MrRyabena/SmartSpot/photo/SceneSpotManager_2x.png

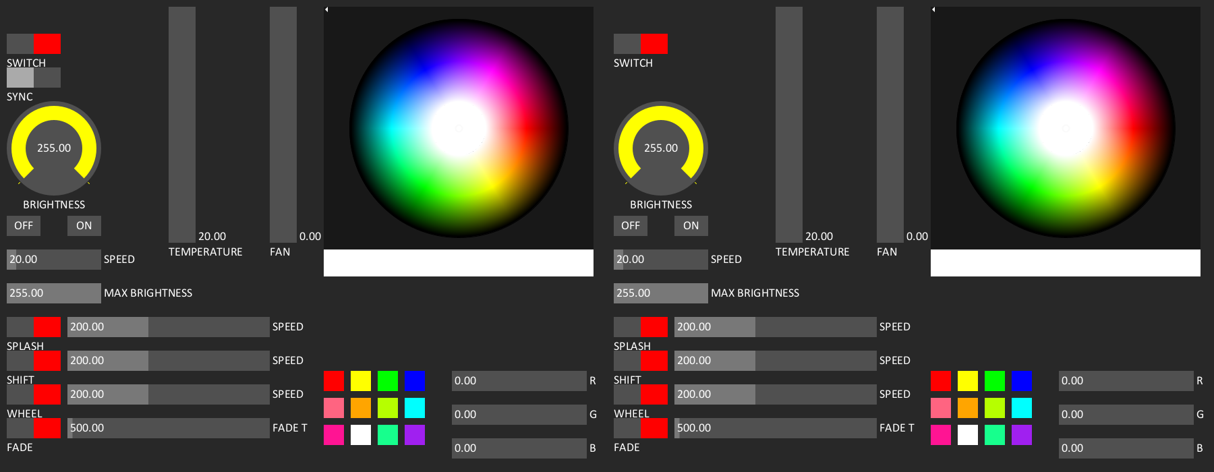
photo/SceneSpotManager_2x.png
