MrRyabena/SmartSpot/schemes/scheme_SmartSpot_v2.0.0.png

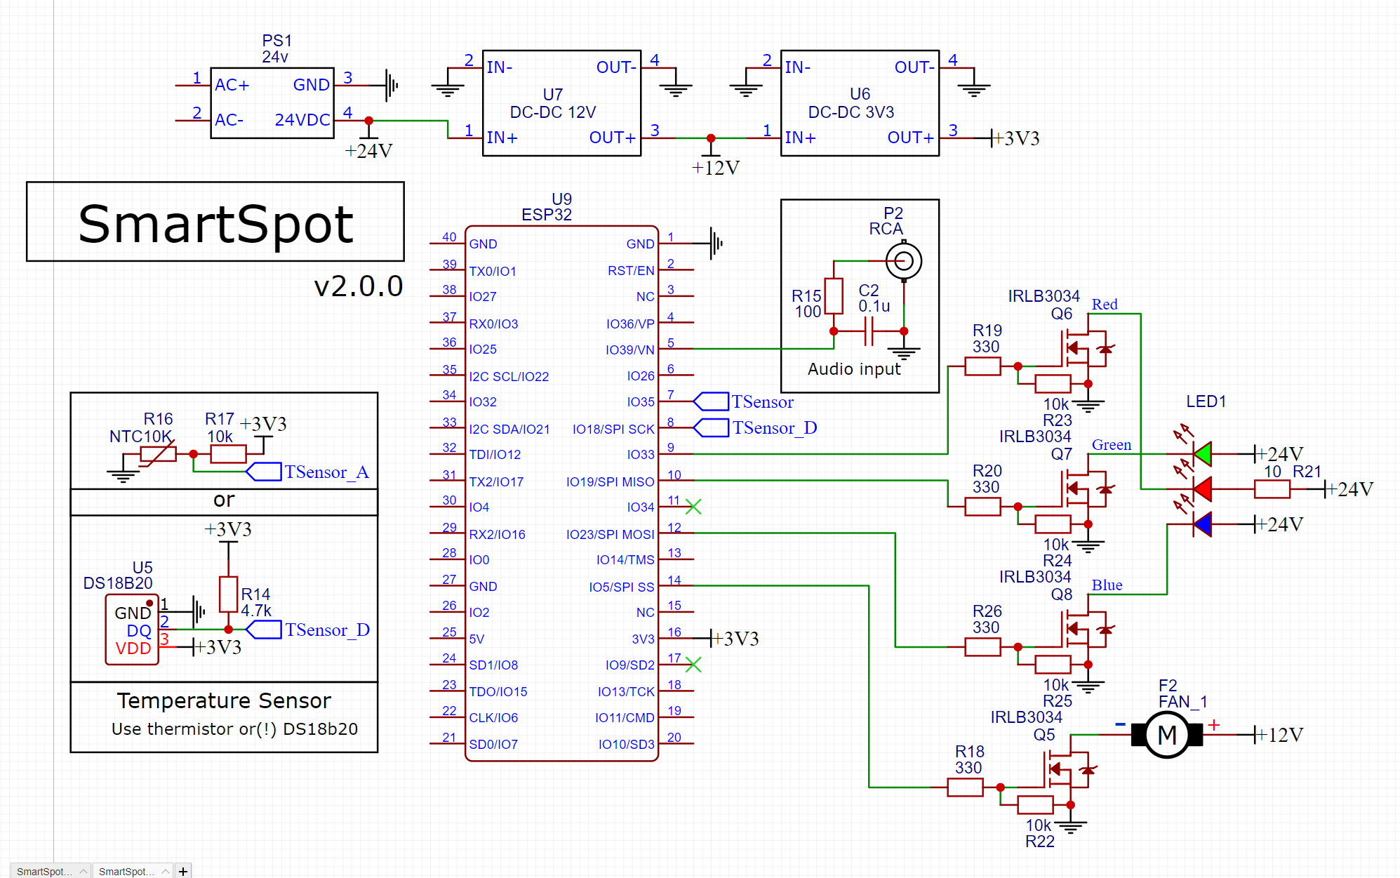
schemes/scheme_SmartSpot_v2.0.0.png
