MrRyabena/SmartSpot/schemes/smartspot_little.png

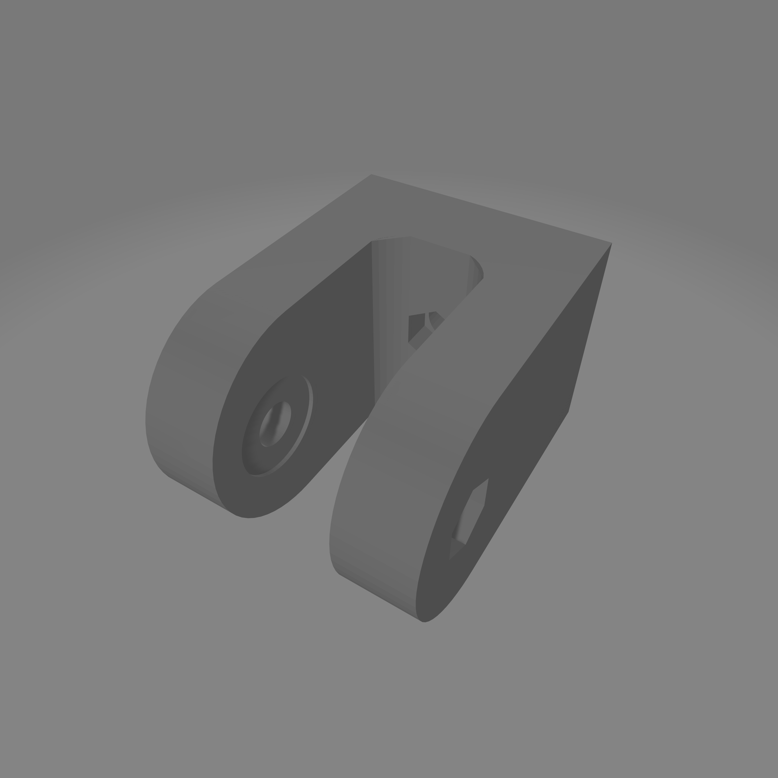
schemes/smartspot_little.png
