MrRyabena/SmartSpot/schemes/smartspot_lower.png

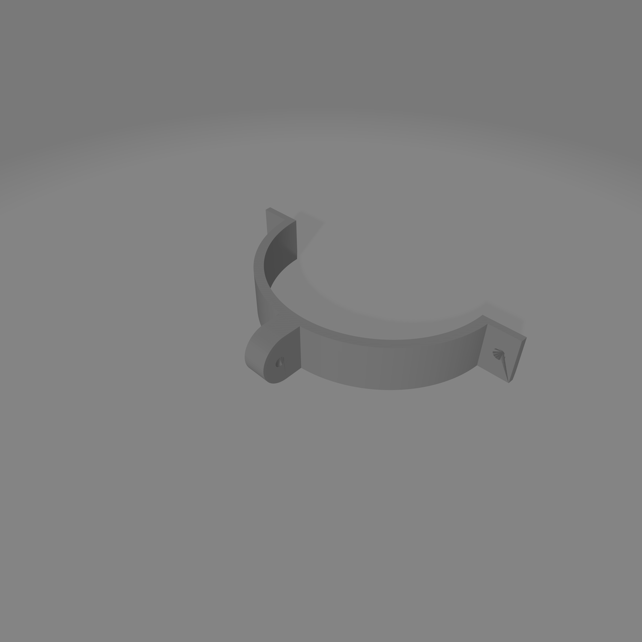
schemes/smartspot_lower.png
