MrRyabena/SmartSpot/schemes/smartspot_upper.png

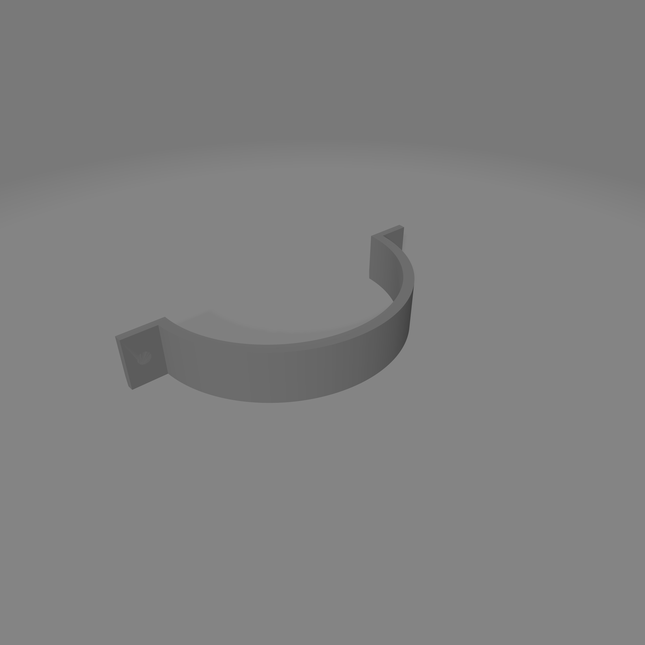
schemes/smartspot_upper.png
