MrRyabena/SmartSpot/3Dmodels/smartspot_little.obj

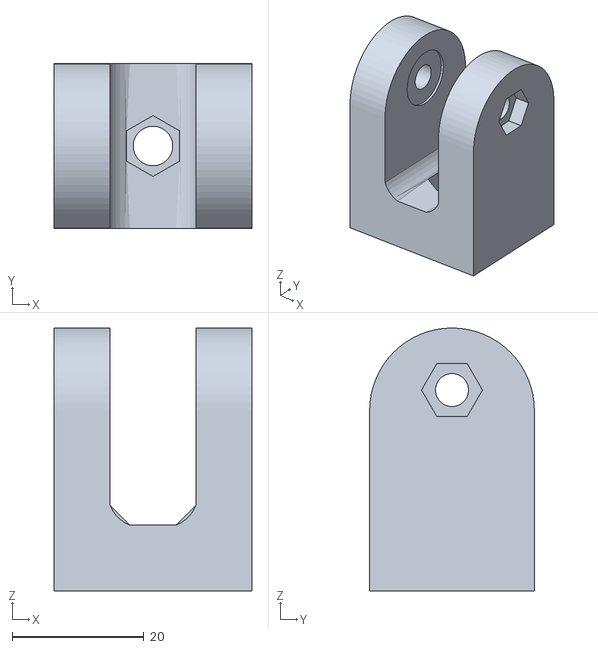
[picture p17: CAD file, 2025-05-09]
3Dmodels/smartspot_little.obj
30.0 x 25.0 x 39.9
