MrRyabena/SmartSpot/3Dmodels/smartspot_lower.obj

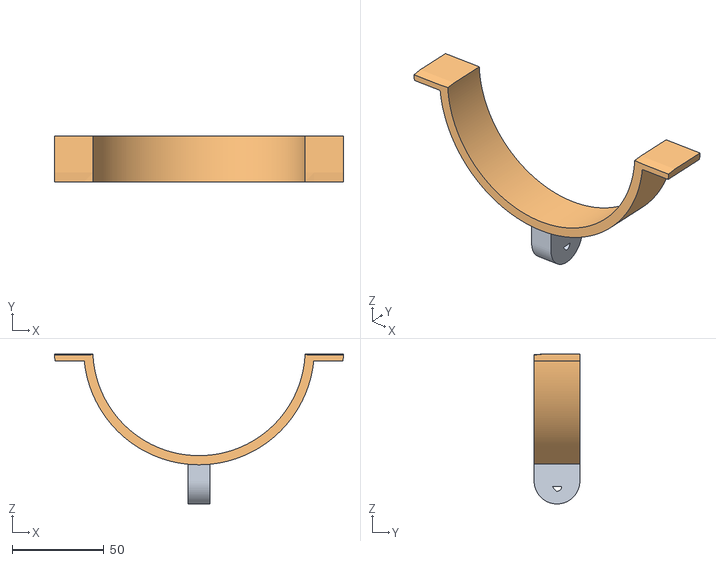
[picture p18: CAD file, 2025-04-13]
3Dmodels/smartspot_lower.obj
157.9 x 25.0 x 81.9
