MrRyabena/SmartSpot/3Dmodels/smartspot_upper.obj

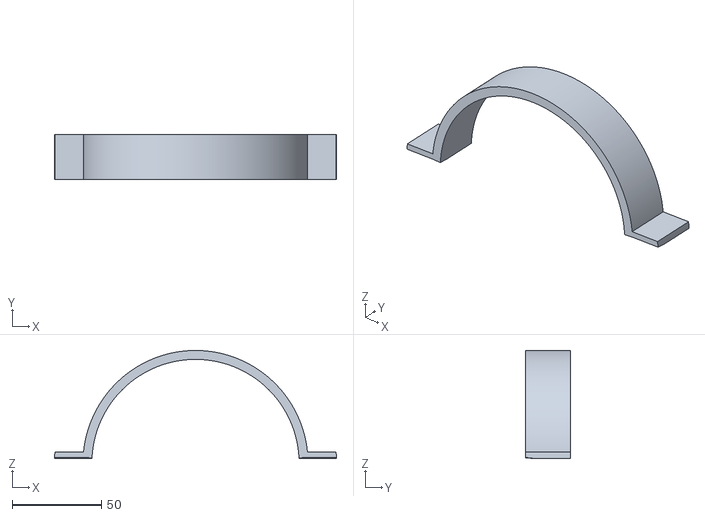
[picture p19: CAD file, 2025-04-13]
3Dmodels/smartspot_upper.obj
157.9 x 25.0 x 60.5
