MrRyabena/SmartSpot/(list of files, cad)

Other CAD files:
3Dmodels/SmartSpot_fasteners.blend
