MrRyabena/SmartSpot/schemes/back_side.pdf

c

i

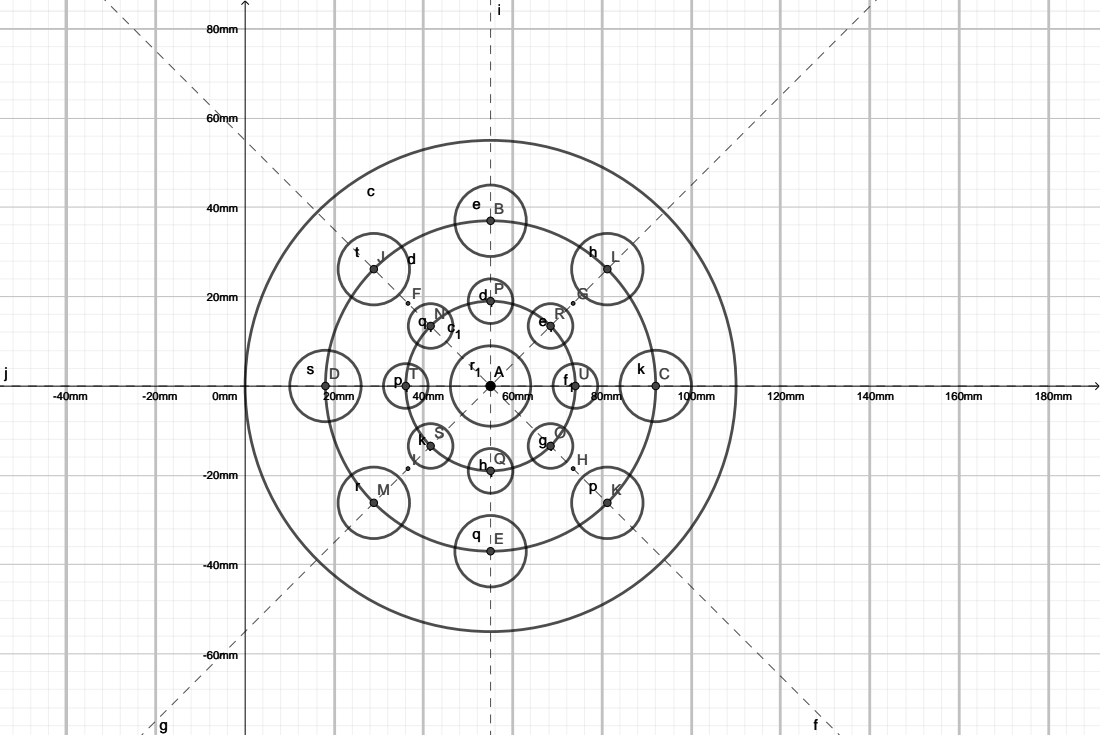
[picture p20: page 1]
