MrRyabena/SmartSpot/schemes/front_side.pdf

c

e

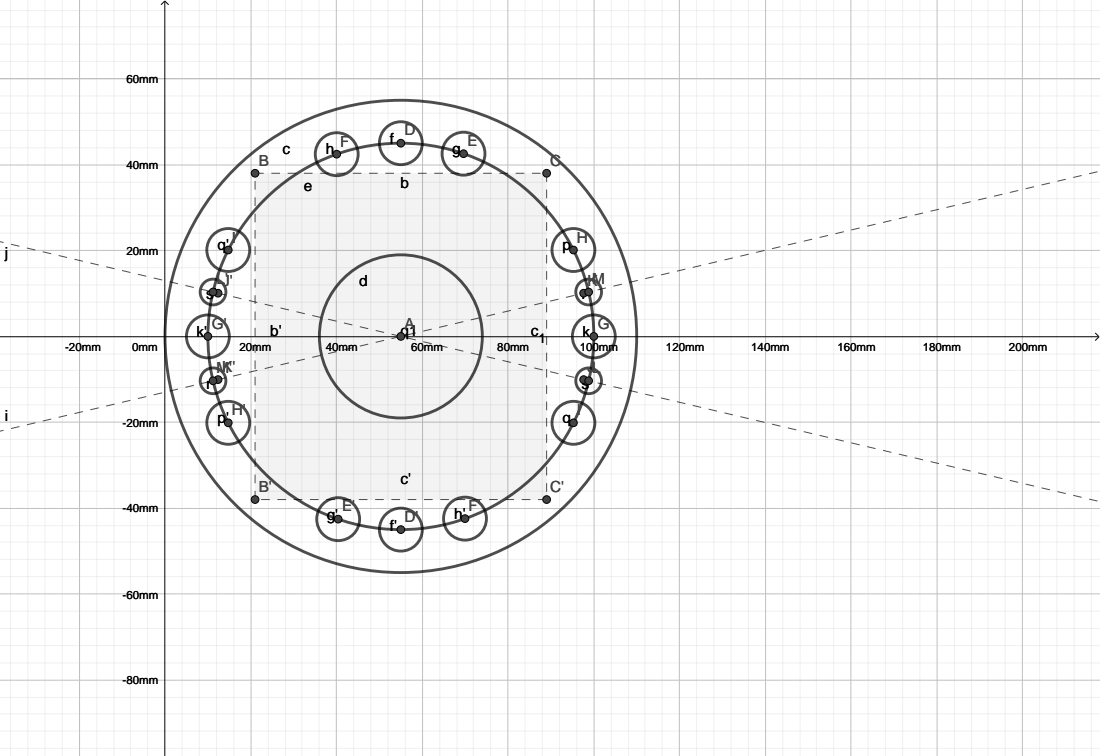
[picture p21: page 1]
