MrRyabena/SmartSpot/(commit log)

2024-09-29 The buttons were inverted
    [SpotGUI.pde]
2024-10-02 Drawings for marking holes
2024-10-03 The prints have been removed, optimized
2024-10-13 Added photos of the assembly
2025-04-13 Added 3d fastener models.
    [SmartSpot_fasteners.blend, smartspot_little.obj, smartspot_lower.obj, smartspot_upper.obj]
2025-04-17 Gaps have been changed.
    [SmartSpot_fasteners.blend, smartspot_little.obj]
2025-04-17 Added a recess for the washer.
    [SmartSpot_fasteners.blend, smartspot_little.obj]
2025-05-09 The hexagonal bolt hole has been enlarged.
    [SmartSpot_fasteners.blend, smartspot_little.obj]
2025-05-14 Temperature sensors have been debugged.
2025-05-21 Added functions for getting temperature and fan.
2025-05-21 Added max power and brightness control.
2025-05-22 Corrected, has a bug.
    [SmartSpotManager.pde, SpotGUI.pde]
2025-05-22 Fixed a bug in spot connection indication.
    [SmartSpotManager.pde, SpotGUI.pde]
2025-05-23 Fixed bug in effect RandomColor.
    [SmartSpotManager.pde, SpotGUI.pde]
2025-10-19 Corrected, added hole.
